Team-4153/LEDs/zia data path.png

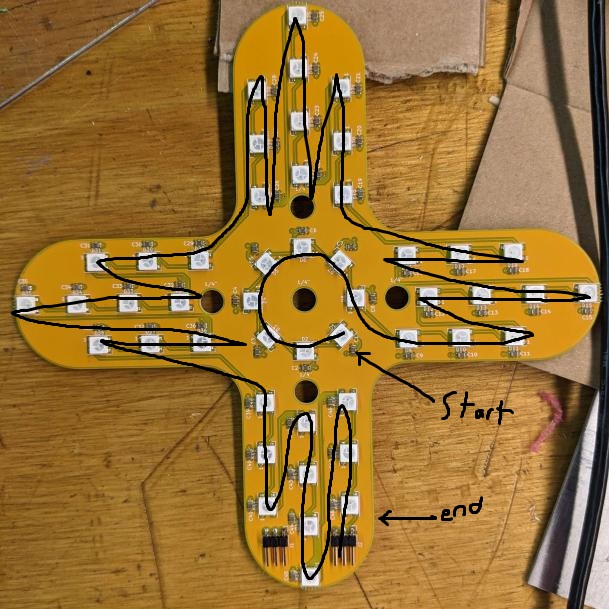
zia data path.png
