Team-4153/LEDs/zia diagram.png

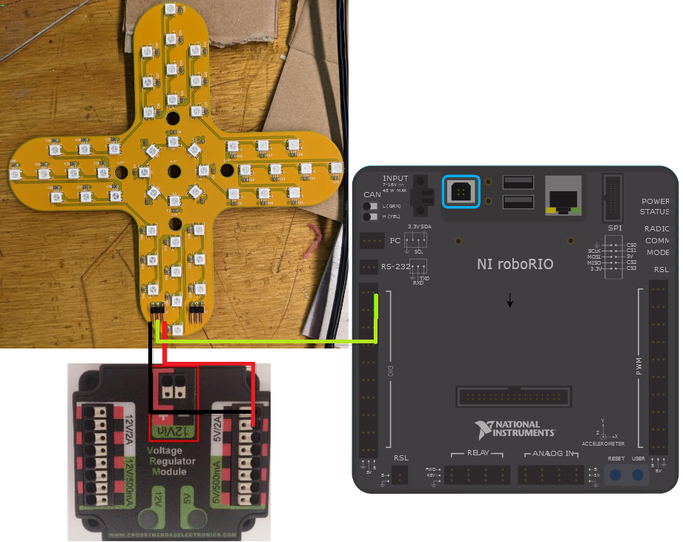
zia diagram.png
