Team-4153/LEDs/schematics/readme.txt

This folder contains all the schematics for the circuit board.

To open them correctly use the free software KiCad

Led Zia.kicad_sch is the file for the electrical schematic
Led Zia.kicad_pcb is the file for the circuit board layout
Most of the other files are different versions, files for manufacturers, and dependencies.
